HexabitzPlatform/HG0B1CEU-Hardware/README.md

# HG0B1CEU-Hardware
Hexabitz STM32G0B1CEU6N DevKit Hardware Design
