HexabitzPlatform/HG0B1CEU-Hardware/Released/BOM/HG0B1CEU.xlsx

 |  | www.hexabitz.com info@hexabitz.com |  |  | Bill Of Materials
Customer | Hexabitz | Revision | 1
Project | STM32G0B1CEU Board | Date | 2022-12-05
Board | STM32G0B1CEU6 DevKit (HG0B1CEU) | Notes
Designator | Description | Manufacturer Part Number | Manufacturer | Octopart Url | Quantity
JP1 , JP2 | Connector Header Through Hole 20 position 0.100" (2.54mm) | Harwin | M20-9992046 | https://octopart.com/m20-9992046-harwin-2627752 | 2
SWD | Connector Header Through Hole, Right Angle 5 position 0.100" (2.54mm) | Harwin | M20-9960245 | https://octopart.com/m20-9960245-harwin-14865948?r=sp | 1
USB_MICRO | USB Connector, 5 Contact(s), Female, Right Angle, Surface Mount Terminal, Locking, Receptacle | Wurth Elektronik | 629105136821 | https://octopart.com/629105136821-wurth+elektronik-19991173?r=sp | 1
BOOT, RESET | Switch Tactile N.O. SPST Round Button PC Pins 0.05A 12VDC 100000Cycle 1.27N Thru-Hole Bulk | C&K Components | PTS645SL43LFS | https://octopart.com/pts645sl43lfs-c%26k+components-7881901?r=sp | 2
R2 | RES SMD 0.0OHM JUMPER 1/10W 0603 | YAGEO [VR] | RC0603JR-070RL | https://octopart.com/rc0603jr-070rl-yageo-1241539?r=sp | 1
R4 ,R5 | Thick Film Resistors - SMD 0603 1/10W 1% 27R T/R-5000 | Royal Ohm | 0603WAF270JT5E | https://octopart.com/0603waf270jt5e-royal+ohm-127860643?r=sp | 2
R1 , R7 | Thick Film Resistors - SMD 0603 270 Ohm 5% Tol | Panasonic | ERJ-3GEYJ271V | https://octopart.com/erj-3geyj271v-panasonic-55560546?r=sp | 2
R3 , R6 | RES 10K Ohm 1% 0603 | RC0603FR-0710KL | Yageo | https://octopart.com/rc0603fr-0710kl-yageo-40025538?r=sp (https://octopart.com/crcw060310k0jneb-vishay-46603269) | 2
C8 | CAP CER 10000PF 50V X7R 0603 | CC0603KRX7R9BB103 | YAGEO | https://octopart.com/cc0603krx7r9bb103-yageo-192938?r=sp (https://octopart.com/c0603c103k5ractu-kemet-133094?r=sp) | 1
C1, C3, C5, C11, C12, C14, C16 | CAP CER 0.1UF 25V X7R 0603 | CGA3E2X8R1E104K080AE | TDK | https://octopart.com/cga3e2x8r1e104k080ae-tdk-68305753?r=sp (https://octopart.com/c0603c104k8ractu-kemet-145075?r=sp&s=9bS9ASSwSEqMCE9KBEQZ0g) | 7
C2 | CAP CER 1 UF 16V X7R 0805 | YAGEO [VA] | CC0805KKX7R7BB105 | https://octopart.com/cc0805kkx7r7bb105-yageo-8376555?r=sp | 1
C4, C7, C9, C10 | CAP CER 4.7UF 16V X7R 0805 | C0805C475K4RACTU | KEMET [VA] | https://octopart.com/c0805c475k4ractu-kemet-22859922?r=sp | 4
FB1 | Ind chip Bead Multi-Layer 30 ohms 25% 100MHZ Ferrite 1,5A 0603Punched paper T/R | TDK | MMZ1608Y300BTA00 | https://octopart.com/mmz1608y300bta00-tdk-7906990?r=sp | 1
D3 | Red 0603 130° Clear 54 mcd 2 V Surface Mount ChipLED | Vishay | VLMS1300-GS08 | https://octopart.com/vlms1300-gs08-vishay-21709201?r=sp&s=0nXJNjGsSbWwqfqWlZv0EA | 1
D2 | Diode Switching 1KV 1A 2-Pin SOD-123FL T/R | MCC | FSM17PL-TP | https://octopart.com/fsm17pl-tp-mcc-57606818?r=sp | 1
D1 | LED Uni-Color True Green 530nm 2-Pin Chip 0603(1608Metric) T/R | Vishay | VLMTG1300-GS08 | https://octopart.com/vlmtg1300-gs08-vishay-21709202?r=sp | 1
U1 | MCU 32-Bit ARM Cortex-M0+ RISC 512kByte Flash 1.7V to 3.6V 48-Pin UFQFPN Tray | STMicroelectronics | STM32G0B1CEU6 | https://octopart.com/stm32g0b1ceu6-stmicroelectronics-116363364?r=sp | 1
X1 | 8,0000MHZ 33pF SMD MURATA Resonators | Murata | CSTNE8M00G550000R0 | https://octopart.com/cstne8m00g550000r0-murata-91406934?r=sp | 1
U2 | 150-mA, 10-V, low-dropout voltage regulator with bypass & enable 5-SOT-23 -40 to 125 | Texas Instruments | TPS76433DBVT | https://octopart.com/tps76433dbvt-texas+instruments-69873?r=sp | 1
