HexabitzPlatform/HG0B1CEU-Hardware/Documentation/HG0B1CEU Schematics.pdf

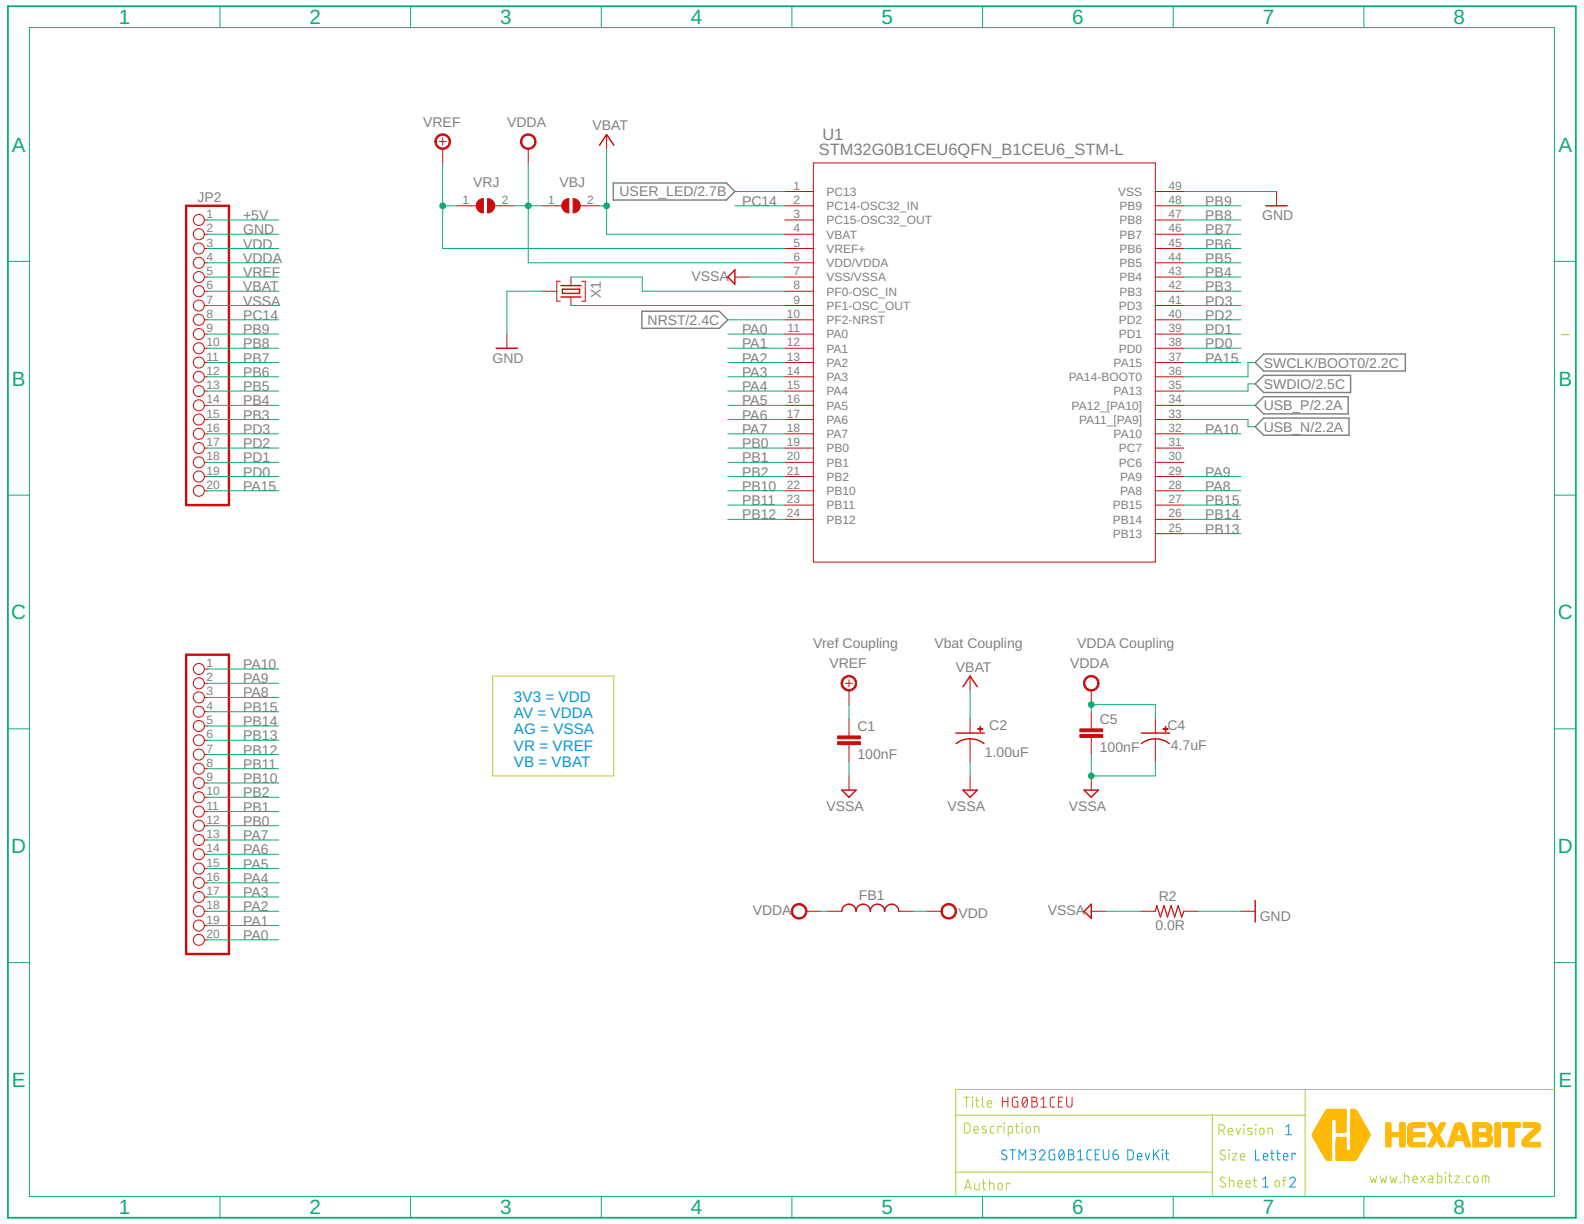
[picture p1: page 1]
