HexabitzPlatform/HG0B1CEU-Hardware/HG0B1CEU6N_V2/Documentation/STM32-G0-Dip-Module.pdf

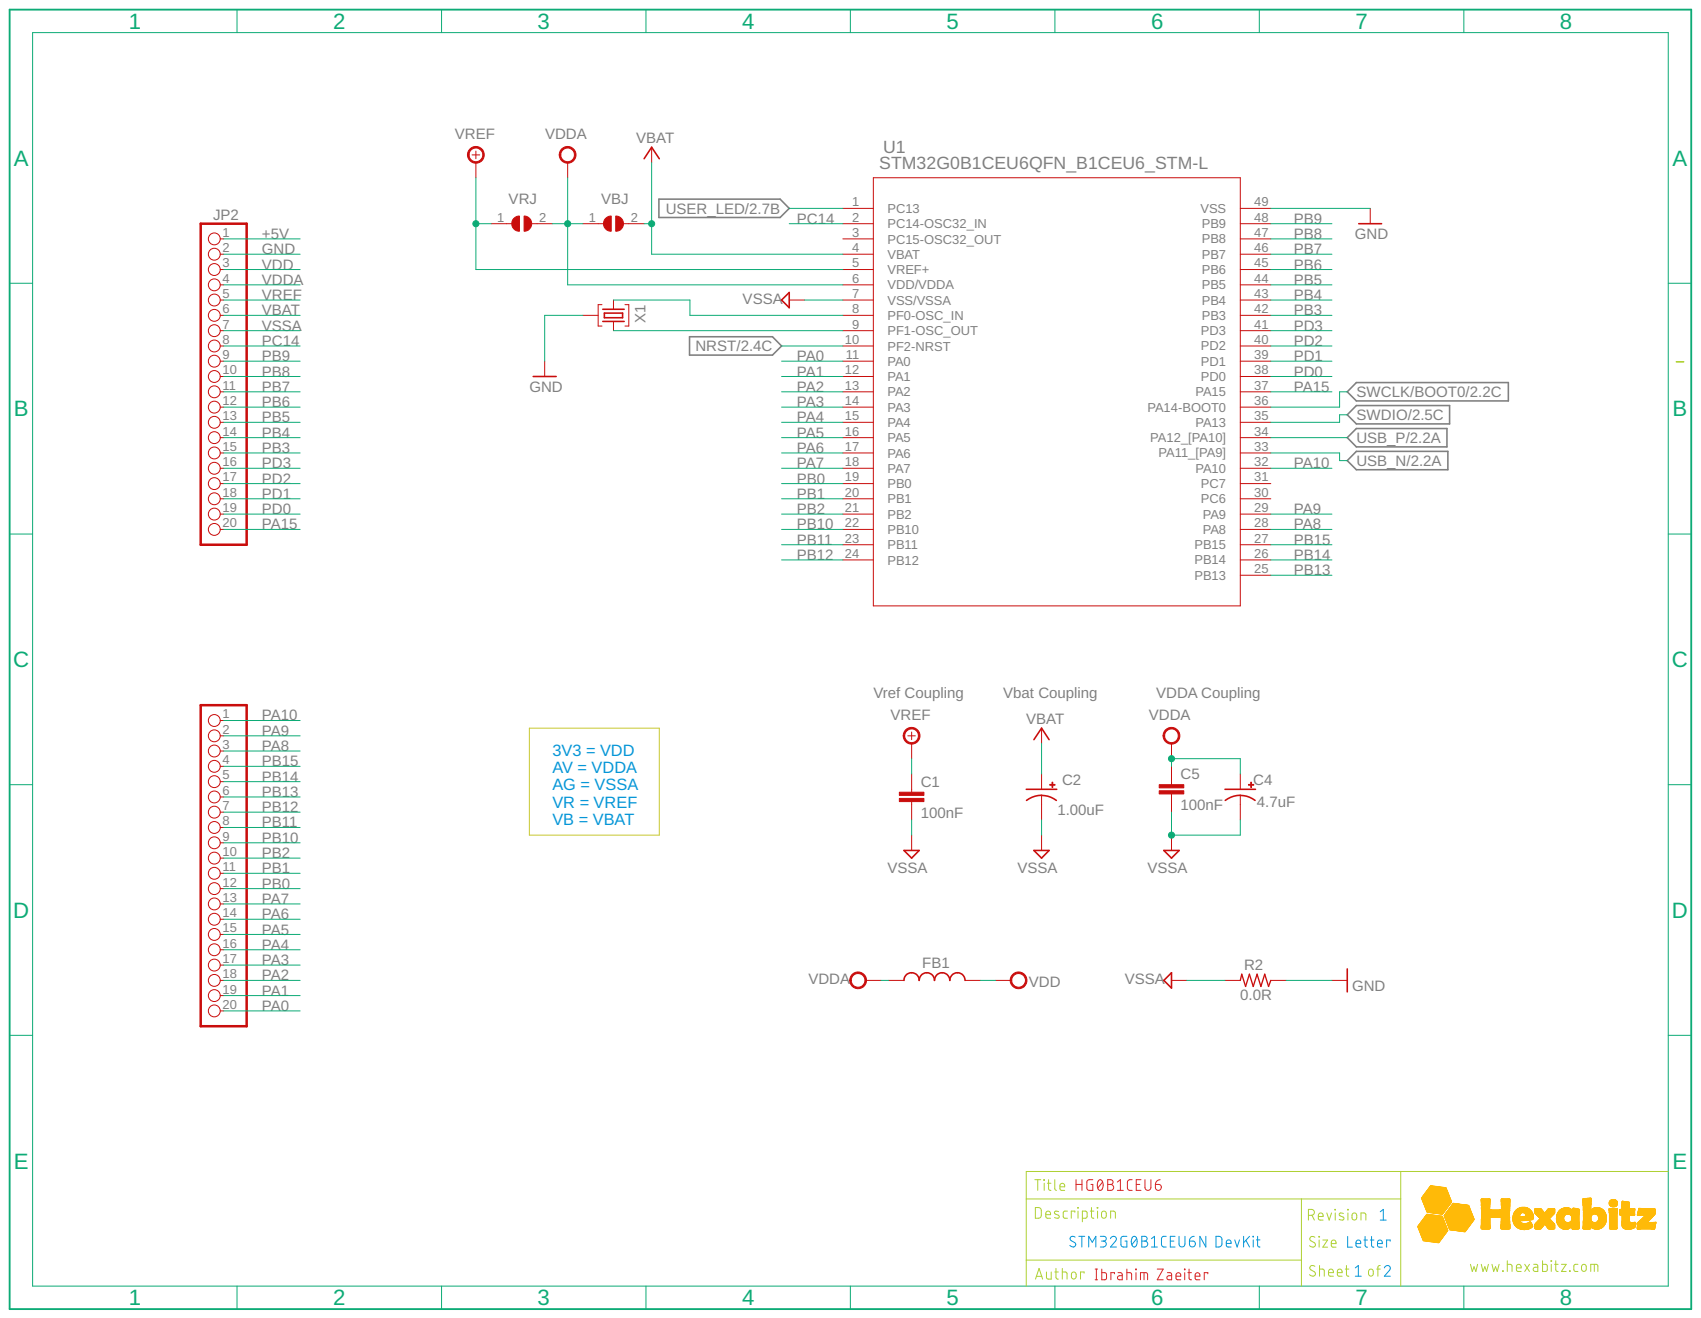
[picture p2: page 1]

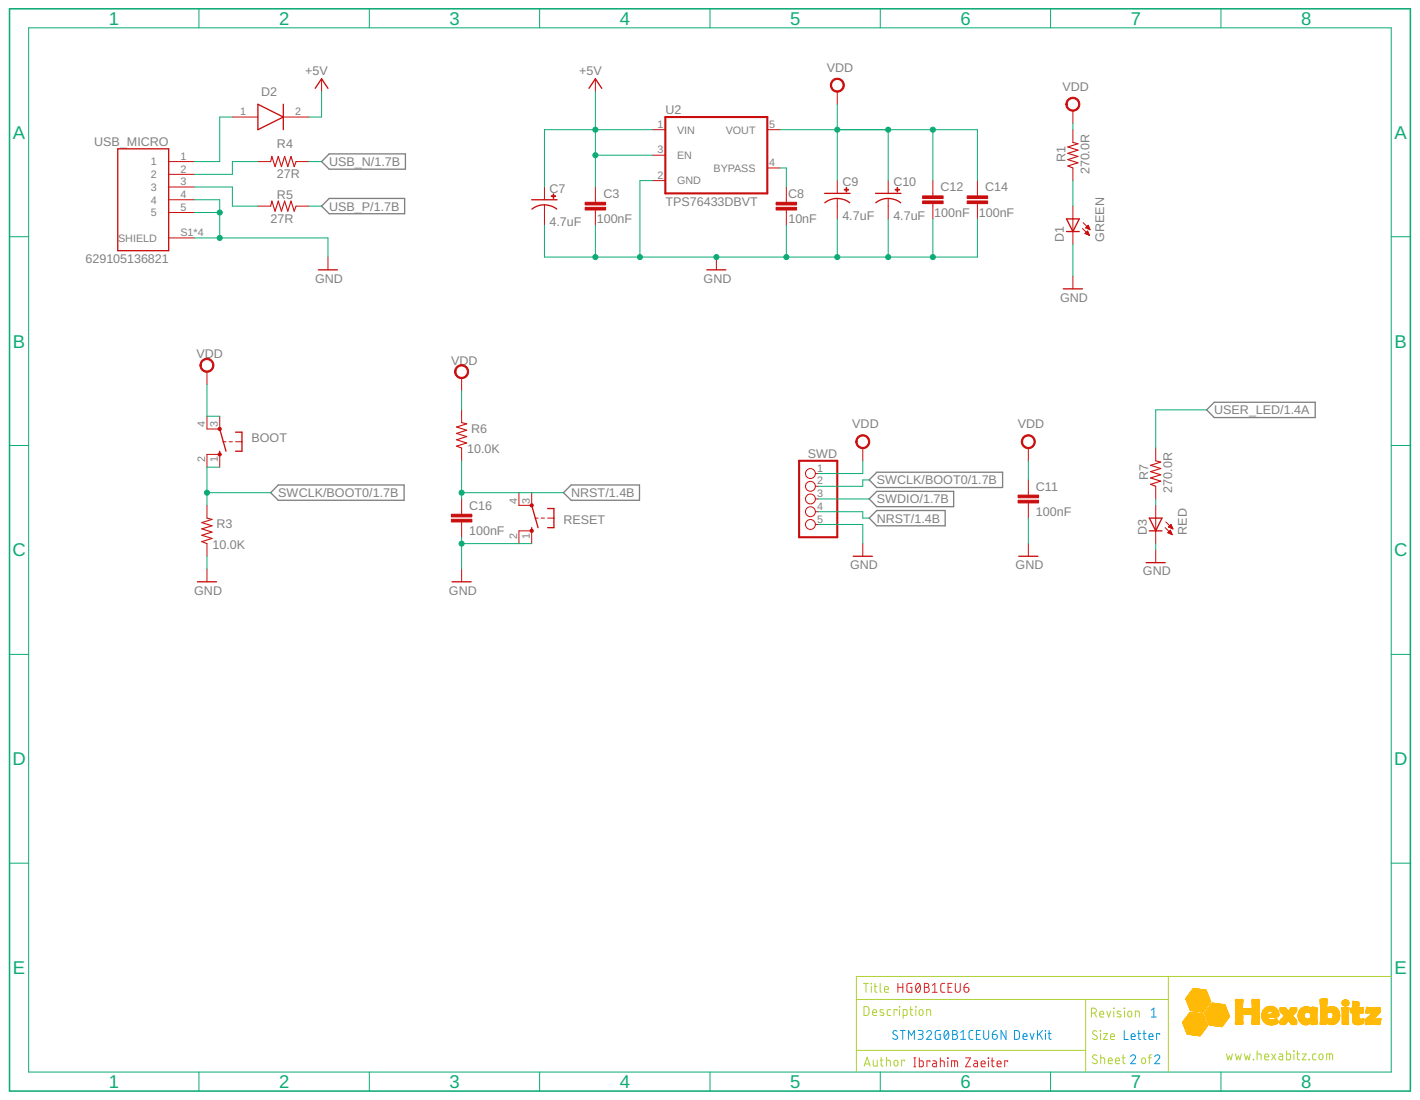
[picture p3: page 2]
