HexabitzPlatform/HG0B1CEU-Hardware/Design/HG0B1CEU.brd

## EAGLE design Design/HG0B1CEU.brd (2022-12-28)

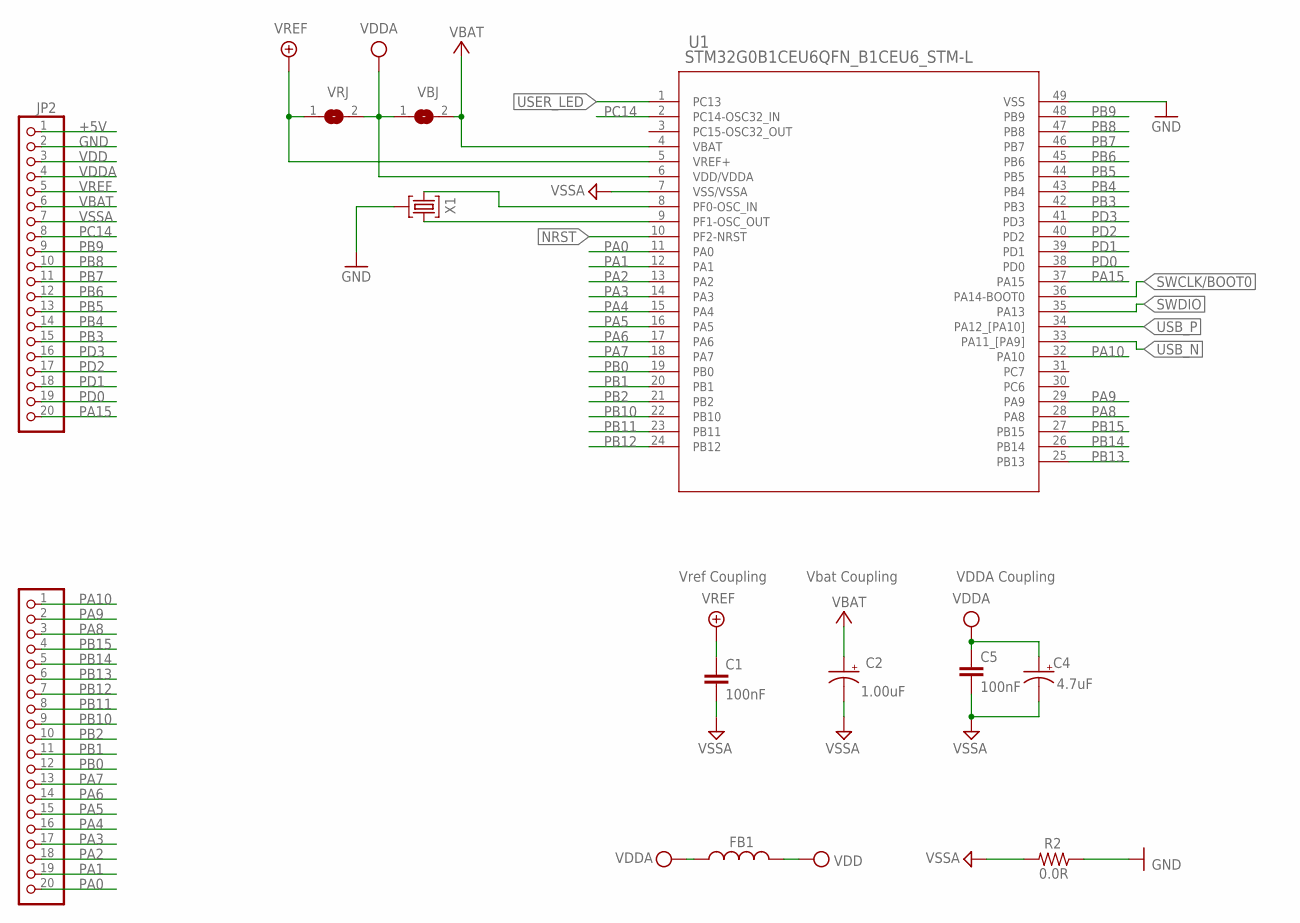
[picture p4: schematic HG0B1CEU.sch, sheet 1]

Parts:
C1: 100nF; C-0603; TOLERANCE 10%; VOLTAGE_RATING 10V; MPN C0603C104K8RACTU
C2: 1.00uF; C-0805-POL; TOLERANCE 10%; VOLTAGE_RATING 16V; MPN CC0805KKX7R7BB105
C4: 4.7uF; C-0805-POL; TOLERANCE 10%; VOLTAGE_RATING 25V; MPN GRM21BC81E475KA12L
C5: 100nF; C-0603; TOLERANCE 10%; VOLTAGE_RATING 10; MPN C0603C104K8RACTU
FB1: FB-TDK_MMZ1608Y300B; MPN MMZ1608Y300B
JP1, JP2: PINHD-1X20; 1X20
R2: 0.0R; R-0603; MPN RC0603JR-070RL
U1: STM32G0B1CEU6QFN_B1CEU6_STM-L; QFN_B1CEU6_STM-L
VBJ: SJ
VRJ: SJ
X1: XTALL_CSTCE8M00G52

Connections:
+5V: JP2.1; also elsewhere on the board
CRYSTAL_N: U1.8 (PF0-OSC_IN), X1.P$1 (1)
CRYSTAL_P: U1.9 (PF1-OSC_OUT), X1.P$3 (3)
GND: JP2.2, R2.1, U1.49 (VSS), X1.P$2 (2); also elsewhere on the board
NRST: U1.10 (PF2-NRST); also elsewhere on the board
PA0: JP1.20, U1.11 (PA0)
PA1: JP1.19, U1.12 (PA1)
PA2: JP1.18, U1.13 (PA2)
PA3: JP1.17, U1.14 (PA3)
PA4: JP1.16, U1.15 (PA4)
PA5: JP1.15, U1.16 (PA5)
PA6: JP1.14, U1.17 (PA6)
PA7: JP1.13, U1.18 (PA7)
PA8: JP1.3, U1.28 (PA8)
PA9: JP1.2, U1.29 (PA9)
PA10: JP1.1, U1.32 (PA10)
PA15: JP2.20, U1.37 (PA15)
PB0: JP1.12, U1.19 (PB0)
PB1: JP1.11, U1.20 (PB1)
PB2: JP1.10, U1.21 (PB2)
PB3: JP2.15, U1.42 (PB3)
PB4: JP2.14, U1.43 (PB4)
PB5: JP2.13, U1.44 (PB5)
PB6: JP2.12, U1.45 (PB6)
PB7: JP2.11, U1.46 (PB7)
PB8: JP2.10, U1.47 (PB8)
PB9: JP2.9, U1.48 (PB9)
PB10: JP1.9, U1.22 (PB10)
PB11: JP1.8, U1.23 (PB11)
PB12: JP1.7, U1.24 (PB12)
PB13: JP1.6, U1.25 (PB13)
PB14: JP1.5, U1.26 (PB14)
PB15: JP1.4, U1.27 (PB15)
PC14: JP2.8, U1.2 (PC14-OSC32_IN)
PD0: JP2.19, U1.38 (PD0)
PD1: JP2.18, U1.39 (PD1)
PD2: JP2.17, U1.40 (PD2)
PD3: JP2.16, U1.41 (PD3)
SWCLK/BOOT0: U1.36 (PA14-BOOT0); also elsewhere on the board
SWDIO: U1.35 (PA13); also elsewhere on the board
USB_N: U1.33 (PA11_[PA9]); also elsewhere on the board
USB_P: U1.34 (PA12_[PA10]); also elsewhere on the board
USER_LED: U1.1 (PC13); also elsewhere on the board
VBAT: C2.1 (+), JP2.6, U1.4 (VBAT), VBJ.2
VDD: FB1.2, JP2.3; also elsewhere on the board
VDDA: C4.1 (+), C5.1, FB1.1, JP2.4, U1.6 (VDD/VDDA), VBJ.1, VRJ.2
VREF: C1.1, JP2.5, U1.5 (VREF+), VRJ.1
VSSA: C1.2, C2.2 (-), C4.2 (-), C5.2, JP2.7, R2.2, U1.7 (VSS/VSSA)

Notes on the sheet:
VDDA Coupling
Vref Coupling
Vbat Coupling

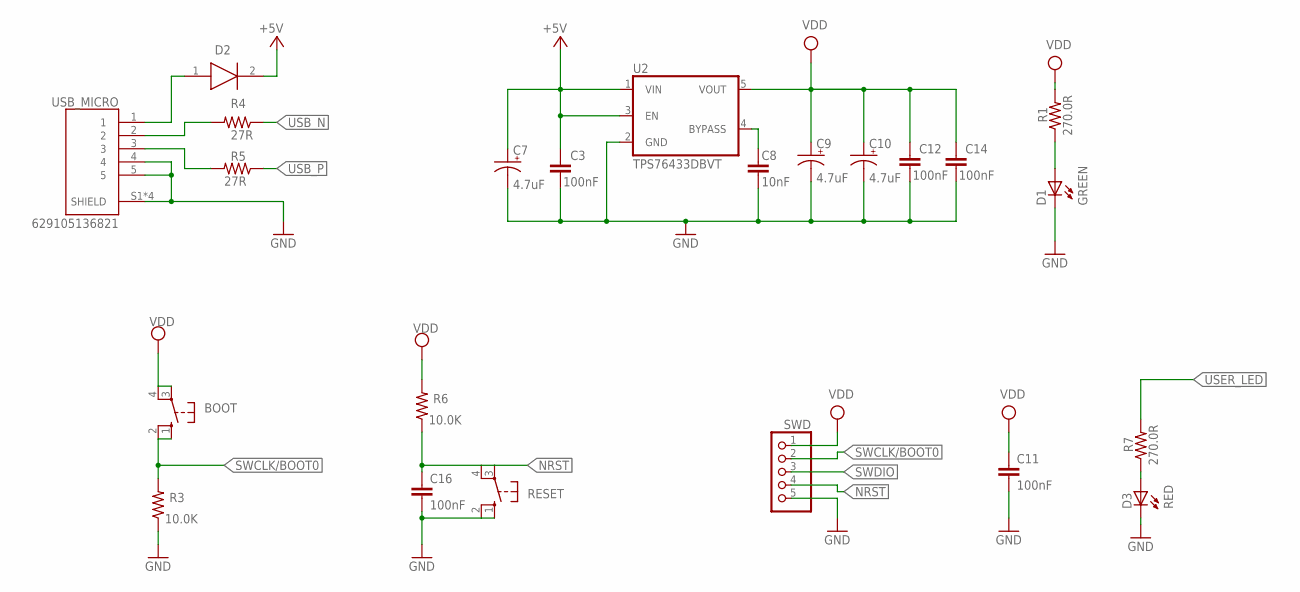
[picture p5: schematic HG0B1CEU.sch, sheet 2]

Parts:
BOOT: 10-XX; B3F-10XX
C3, C12, C14: 100nF; C-0603; TOLERANCE 10%; VOLTAGE_RATING 10; MPN C0603C104K8RACTU
C7, C9, C10: 4.7uF; C-0805-POL; TOLERANCE 10%; VOLTAGE_RATING 25V; MPN GRM21BC81E475KA12L
C8: 10nF; C-0603; TOLERANCE 10%; VOLTAGE_RATING 10; MPN C0603C104K8RACTU
C11, C16: 100nF; C-0603; TOLERANCE 10%; VOLTAGE_RATING 10V; MPN C0603C104K8RACTU
D1: GREEN; VLMS1300-GS08; MPN VLMS1300-GS08
D2: FSM17PL-TP
D3: RED; VLMS1300-GS08; MPN VLMS1300-GS08
R1, R7: 270.0R; R-0603; TOLERANCE 1%; MPN RC0603FR-07270RL
R3, R6: 10.0K; R-0603; TOLERANCE 5%; MPN RC0603JR-0710KL
R4, R5: 27R; R-0603; TOLERANCE 5%; MPN RC0603JR-0710KL
RESET: 10-XX; B3F-10XX
SWD: PINHD-1X5/90; 1X05/90
U2: TPS76433DBVT; SOT25
USB_MICRO: 629105136821; WE_629105136821

Connections:
+5V: C3.1, C7.1 (+), D2.2 (K), U2.1 (VIN), U2.3 (EN); also elsewhere on the board
D_N: R4.2, USB_MICRO.2
D_P: R5.2, USB_MICRO.3
GND: C3.2, C7.2 (-), C8.2, C9.2 (-), C10.2 (-), C11.2, C12.2, C14.2, C16.2, D1.C, D3.C, R3.1, RESET.1 (S), RESET.2 (S1), SWD.5, U2.2 (GND), USB_MICRO.4, USB_MICRO.5, USB_MICRO.S1 (SHIELD), USB_MICRO.S2 (SHIELD), USB_MICRO.S3 (SHIELD), USB_MICRO.S4 (SHIELD); also elsewhere on the board
unnamed: D2.1 (A), USB_MICRO.1
unnamed: D3.A, R7.1
unnamed: D1.A, R1.1
unnamed: C8.1, U2.4 (BYPASS)
NRST: C16.1, R6.1, RESET.3, RESET.4 (P1), SWD.4; also elsewhere on the board
SWCLK/BOOT0: BOOT.1 (S), BOOT.2 (S1), R3.2, SWD.2; also elsewhere on the board
SWDIO: SWD.3; also elsewhere on the board
USB_N: R4.1; also elsewhere on the board
USB_P: R5.1; also elsewhere on the board
USER_LED: R7.2; also elsewhere on the board
VDD: BOOT.3, BOOT.4 (P1), C9.1 (+), C10.1 (+), C11.1, C12.1, C14.1, R1.2, R6.2, SWD.1, U2.5 (VOUT); also elsewhere on the board

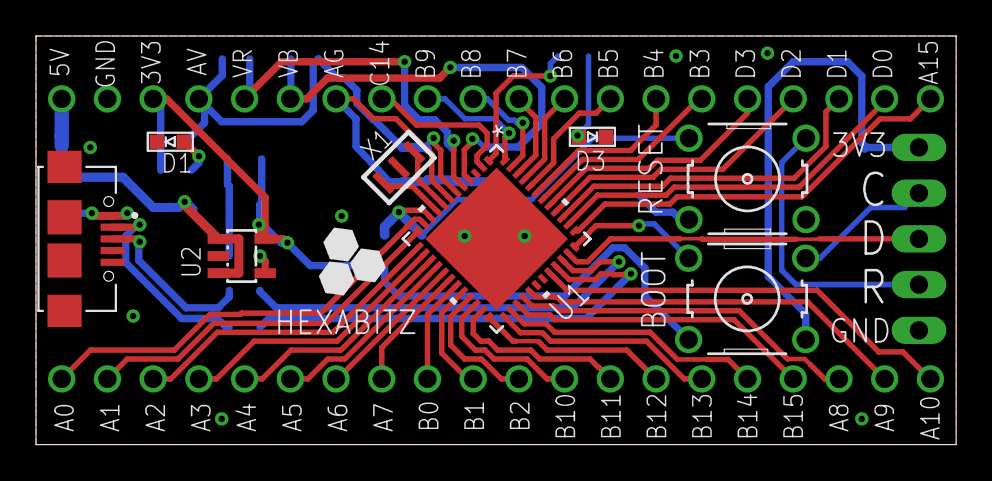
[picture p6: board HG0B1CEU.brd from above]

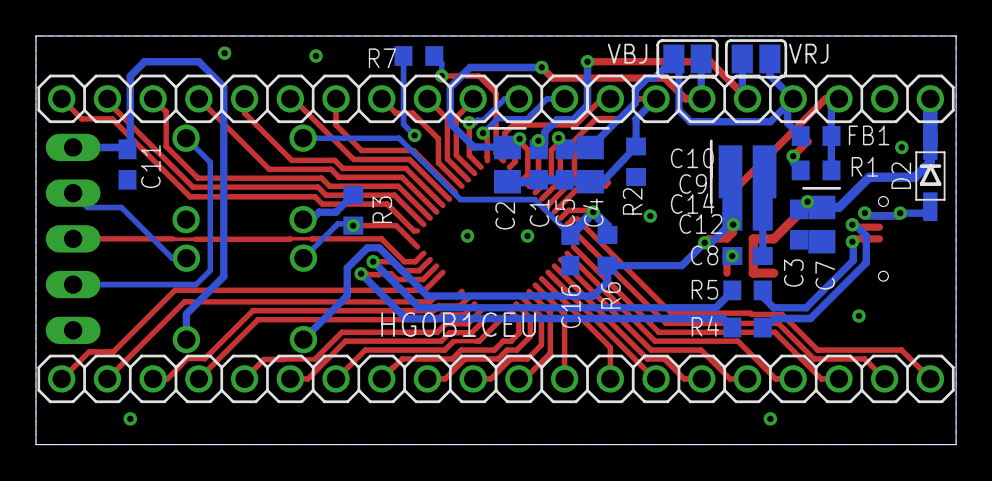
[picture p7: board HG0B1CEU.brd from below]

Board: 2 copper layers, 51.1 x 22.7 mm, 35 parts (24 on the bottom side), 54 nets.
