HexabitzPlatform/HG0B1CEU-Hardware/(commit log)

2022-08-23 Adding the Hardware Design files
    [HG0B1CEU6N.xlsx, STM32-G0-Dip-Module.brd, STM32-G0-Dip-Module.sch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]
2022-09-24 -Changing the Schematic design stile -Correcting some BOM-file data
    [HG0B1CEU6N.xlsx, STM32-G0-Dip-Module.brd, STM32-G0-Dip-Module.sch]
2022-12-21 -Changing the electronic design and layout to improve the performance and ease of use
    [HG0B1CEU.xlsx, HG0B1CEU6N.xlsx, STM32-G0-Dip-Module.brd, STM32-G0-Dip-Module.sch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]
2022-12-28 -- Repairing some issues in the layout that related to keepout margins of the parts
    [STM32-G0-Dip-Module.brd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]
2023-02-13 -Correcting some documentaion issues
    [HG0B1CEU.xlsx, STM32-G0-Dip-Module.sch]
2024-03-07 Fix documentation issue
    [HG0B1CEU.xlsx, STM32-G0-Dip-Module.brd, STM32-G0-Dip-Module.sch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]
2024-05-15 Update the BOM Standrize the files names
    [HG0B1CEU.brd, HG0B1CEU.sch, HG0B1CEU.xlsx, STM32-G0-Dip-Module.sch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]
